slesinger/bobik_robot/meshes/wheel.png

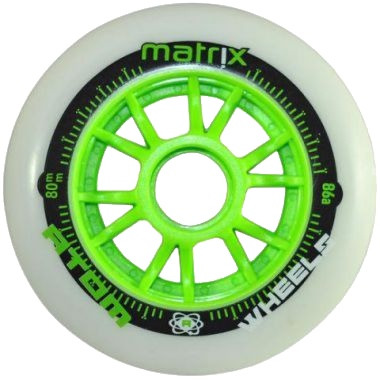
meshes/wheel.png
