slesinger/bobik_robot/docs/CAD/bobik-assembly.FCStd

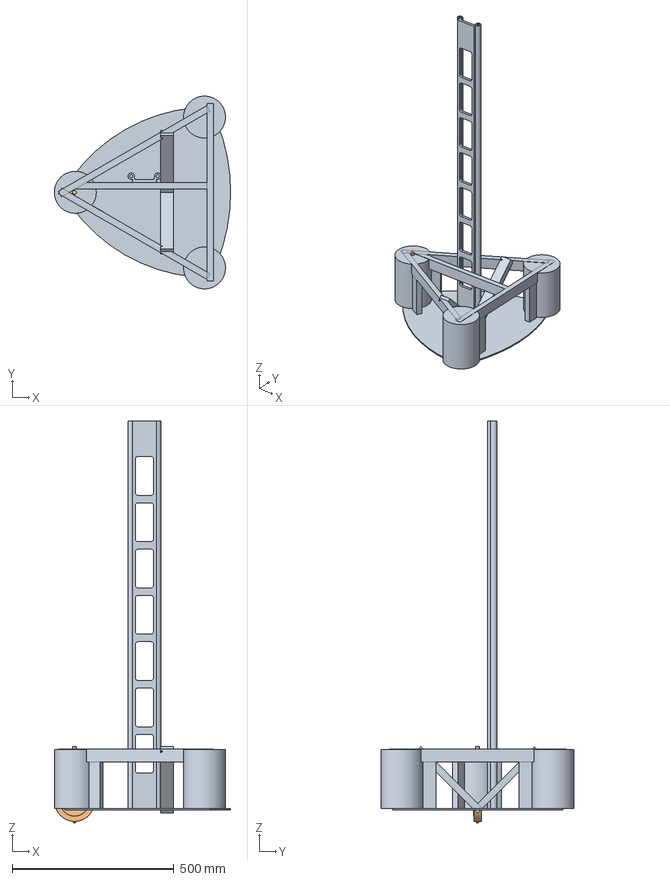
[picture p2: CAD file, 2022-05-19]
docs/CAD/bobik-assembly.FCStd
545.7 x 596.9 x 1244.4 mm
base-fixed_001
drive-module-holder_v2_001
