slesinger/bobik_robot/docs/CAD/base_link/torso-stepper-bearing.FCStd

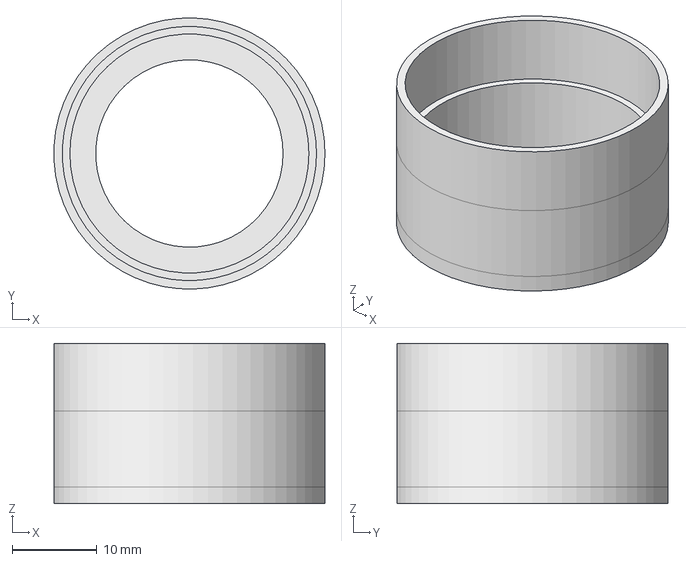
[picture p3: CAD file, 2022-06-24]
docs/CAD/base_link/torso-stepper-bearing.FCStd
32.0 x 32.0 x 18.9 mm
