slesinger/bobik_robot/docs/CAD/caster_rotation_link/drive-rotation-tgear176-Cut.stl

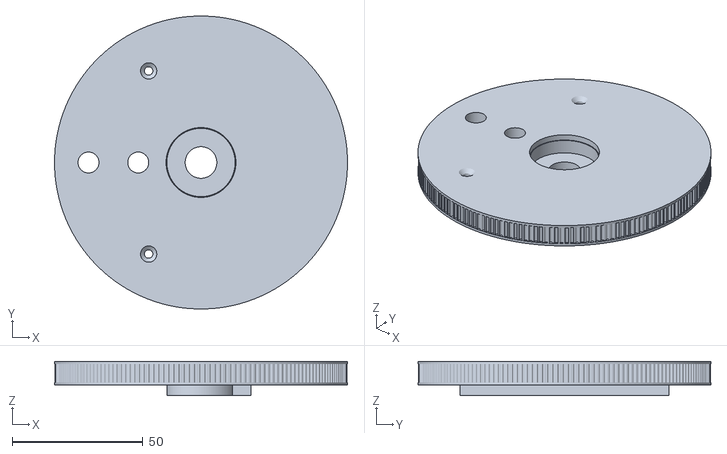
[picture p4: CAD file, 2022-05-19]
docs/CAD/caster_rotation_link/drive-rotation-tgear176-Cut.stl
112.0 x 112.0 x 13.0
