slesinger/bobik_robot/docs/CAD/electrical/imu-holder.stl

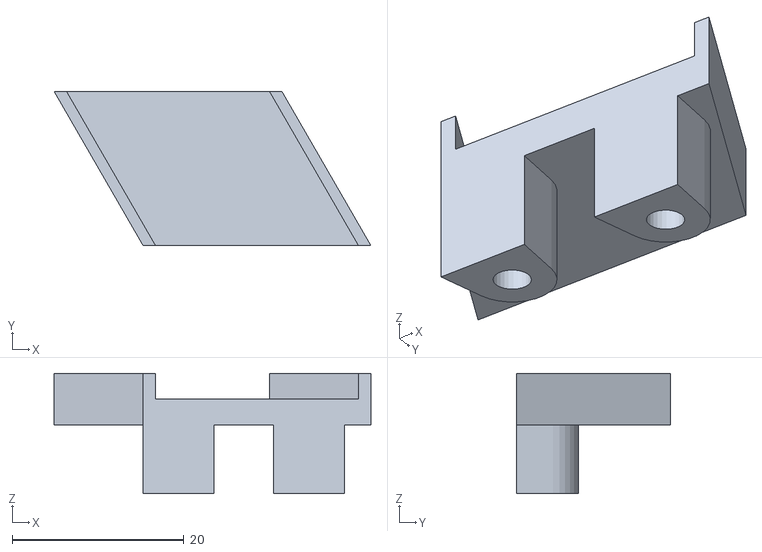
[picture p5: CAD file, 2022-07-30]
docs/CAD/electrical/imu-holder.stl
37.0 x 18.0 x 14.0
