slesinger/bobik_robot/docs/CAD/head_pan_link/head_pan_link.FCStd

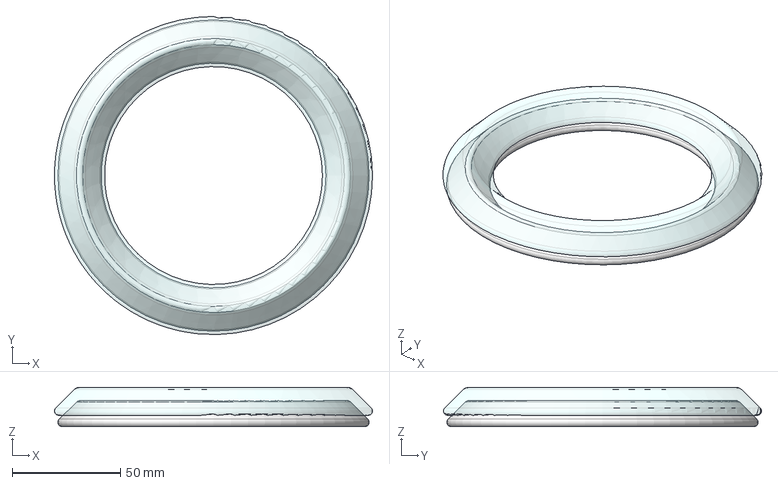
[picture p6: CAD file, 2022-06-17]
docs/CAD/head_pan_link/head_pan_link.FCStd
147.2 x 147.2 x 18.1 mm
