slesinger/bobik_robot/docs/mechanical/arm.FCStd

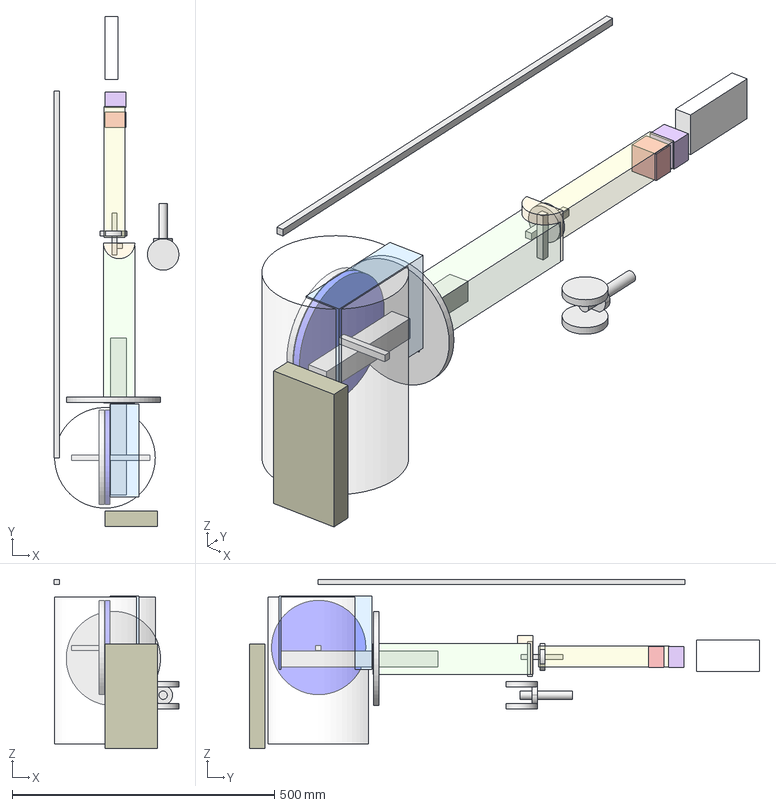
[picture p7: CAD file, 2022-05-19]
docs/mechanical/arm.FCStd
238.0 x 973.0 x 323.0 mm
torso_lift_link
shoulder_pan_link
shoulder_left_link
upper_arm_roll_link
forearm_roll_link
wrist flex link
wrist roll_link
gripper palm link
shoulder-palmwrist-measure
shoulder_tbelt
shoulder_forspring
shoulder_axis
upper_am_roll-axis
elbow_flex_link
elbow_flex_link-axis
forearm roll joint-axis
