slesinger/bobik_robot/docs/CAD/base_link/torso-stepper-holder.FCStd

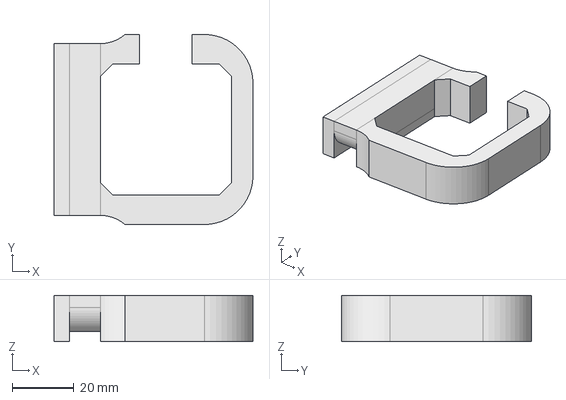
[picture p8: CAD file, 2022-06-24]
docs/CAD/base_link/torso-stepper-holder.FCStd
64.4 x 61.5 x 15.0 mm
