slesinger/bobik_robot/docs/CAD/bobik-urdf-meshes.FCStd

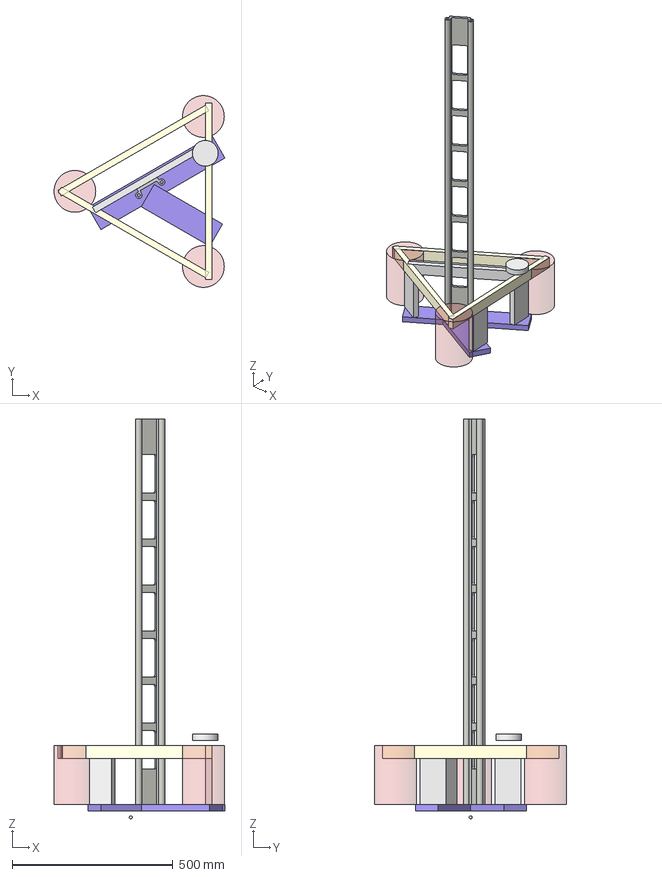
[picture p9: CAD file, 2022-05-19]
docs/CAD/bobik-urdf-meshes.FCStd
531.9 x 596.9 x 1245.0 mm
triangle
ZERO
prostredni
lidar
plech100
plech101
