slesinger/bobik_robot/docs/CAD/caster_rotation_link/drive-module-holder_v2.FCStd

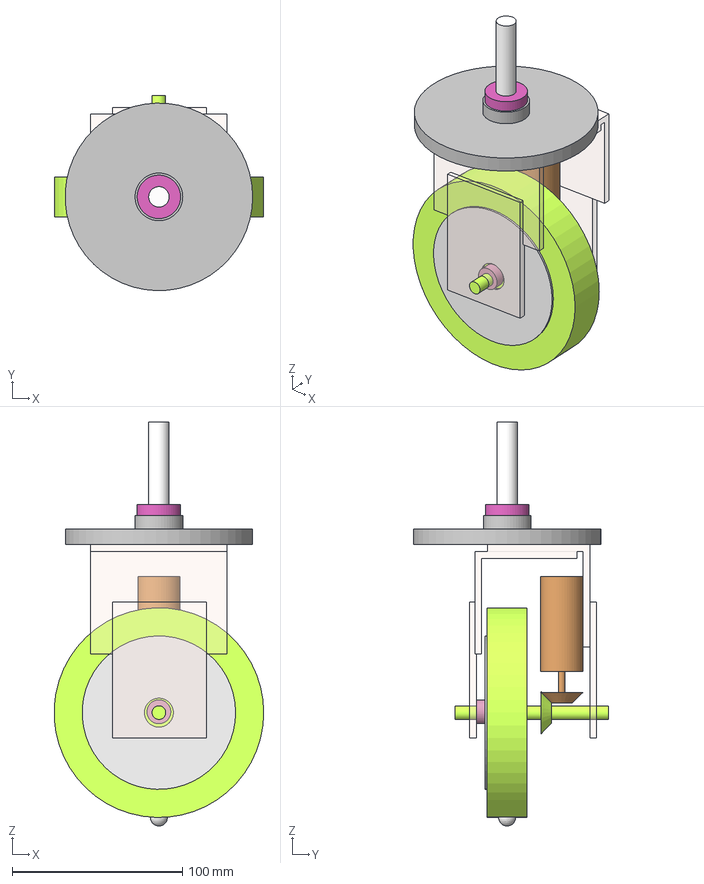
[picture p10: CAD file, 2022-05-19]
docs/CAD/caster_rotation_link/drive-module-holder_v2.FCStd
122.9 x 114.5 x 237.0 mm
ZERO
axial-bearing
rotation-axis
motor001
matka
Ushape
wheen_and_axis
wheel_encoder
rotation
