slesinger/bobik_robot/docs/CAD/electrical/controlpanel-holder.stl

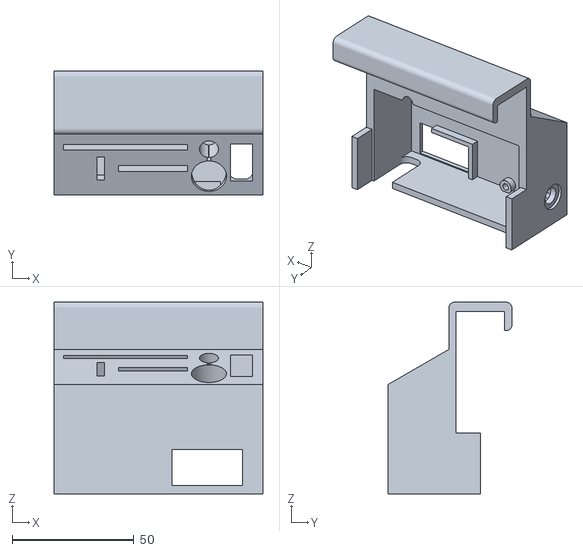
[picture p11: CAD file, 2022-07-30]
docs/CAD/electrical/controlpanel-holder.stl
86.0 x 51.0 x 78.9
