slesinger/bobik_robot/docs/CAD/head_pan_link/temp-kinect.FCStd

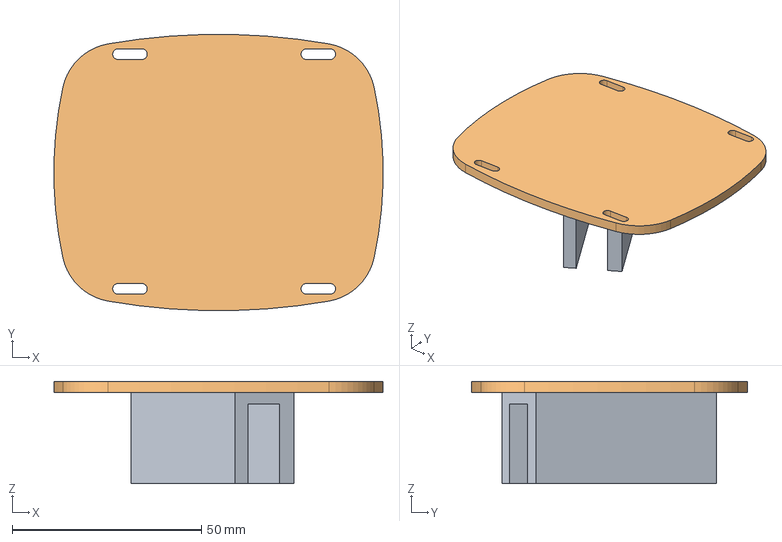
[picture p12: CAD file, 2022-06-17]
docs/CAD/head_pan_link/temp-kinect.FCStd
86.9 x 72.9 x 27.0 mm
