slesinger/bobik_robot/docs/CAD/base_link/rotation-absolute-holder.FCStd

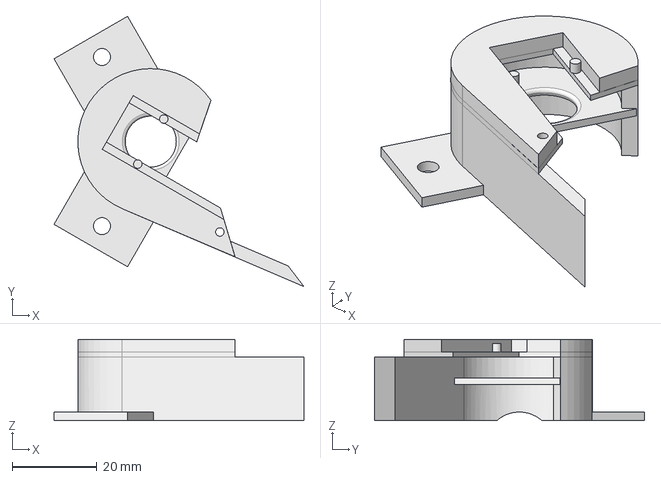
[picture p13: CAD file, 2022-05-19]
docs/CAD/base_link/rotation-absolute-holder.FCStd
58.9 x 63.7 x 19.1 mm
