slesinger/bobik_robot/docs/CAD/caster_rotation_link/rotation-magnet-holder.FCStd

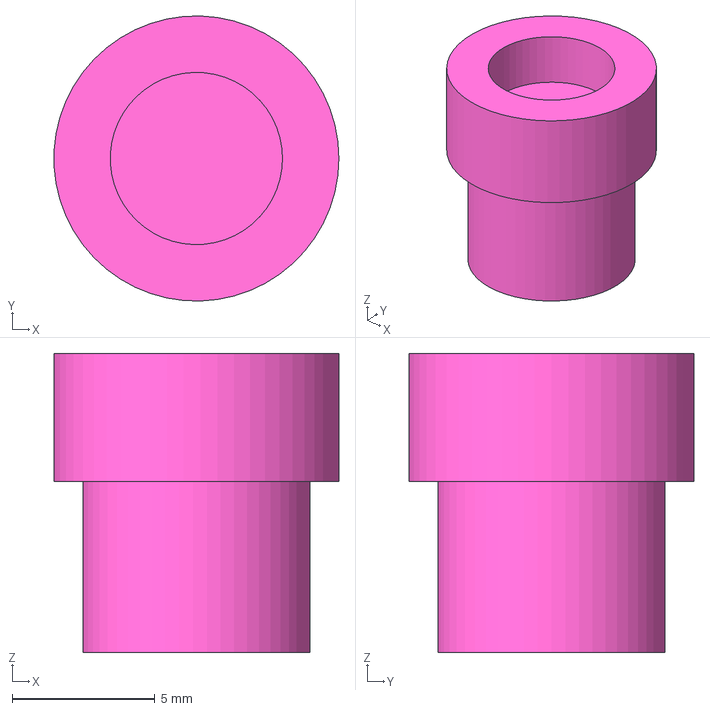
[picture p14: CAD file, 2022-05-19]
docs/CAD/caster_rotation_link/rotation-magnet-holder.FCStd
9.99 x 10.00 x 10.5 mm
