slesinger/bobik_robot/docs/CAD/head_pan_link/head_pan_link_v2.FCStd

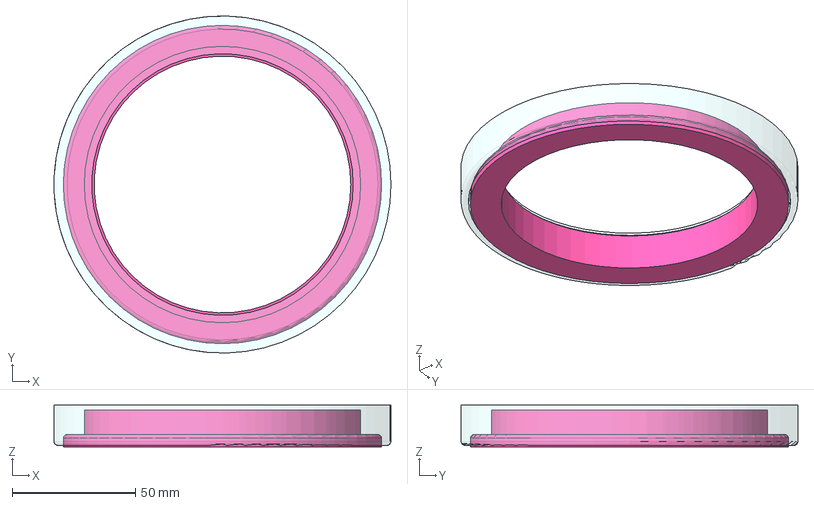
[picture p15: CAD file, 2022-06-17]
docs/CAD/head_pan_link/head_pan_link_v2.FCStd
136.6 x 136.5 x 16.9 mm
