slesinger/bobik_robot/docs/CAD/base_link/base_link.FCStd

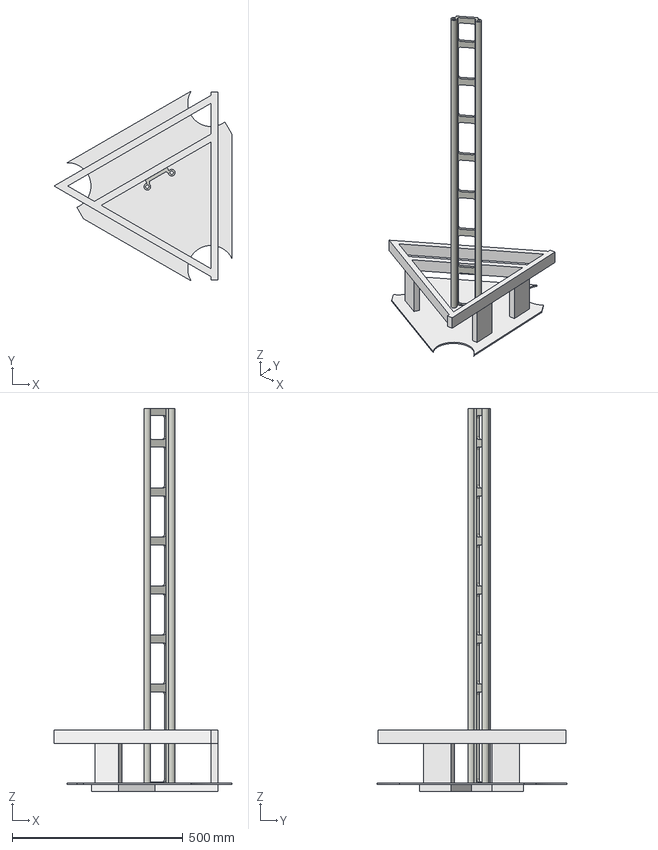
[picture p16: CAD file, 2022-05-19]
docs/CAD/base_link/base_link.FCStd
520.2 x 555.3 x 1120.0 mm
triangle
stand-front-left
stand-front-right
stand-rear
y-bottom
