slesinger/bobik_robot/docs/CAD/electrical/imu.FCStd

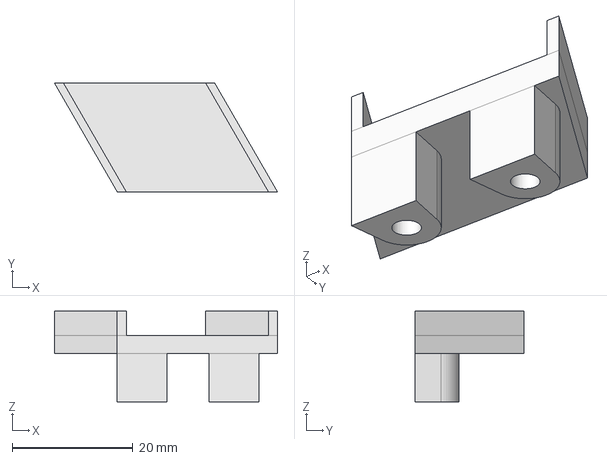
[picture p17: CAD file, 2022-07-09]
docs/CAD/electrical/imu.FCStd
37.0 x 18.0 x 15.0 mm
