slesinger/bobik_robot/docs/CAD/base_link/rotation-motor-holder.FCStd

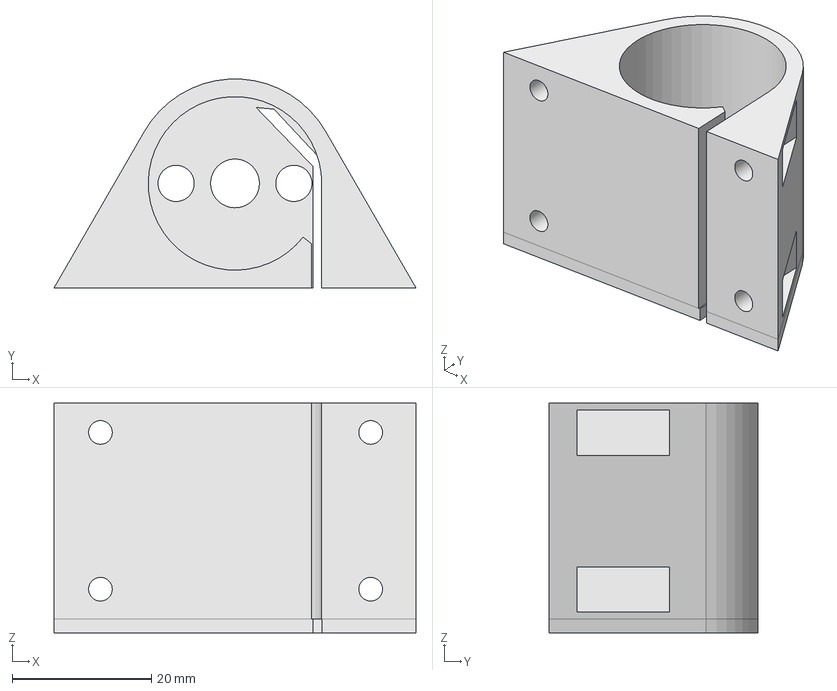
[picture p18: CAD file, 2022-05-19]
docs/CAD/base_link/rotation-motor-holder.FCStd
52.0 x 30.0 x 33.0 mm
