slesinger/bobik_robot/docs/CAD/caster_rotation_link/drive-motor-holder-a.FCStd

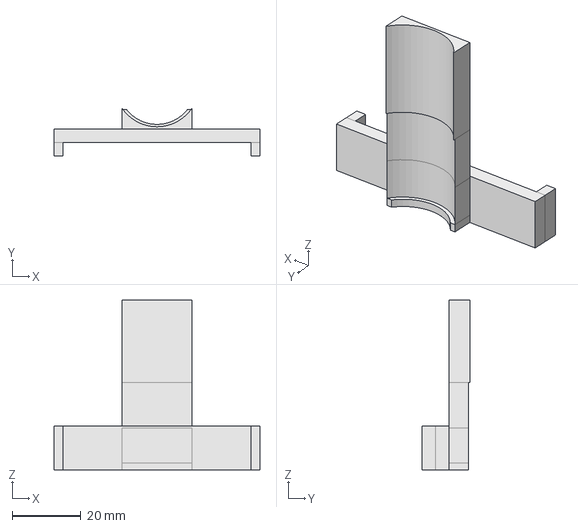
[picture p19: CAD file, 2022-05-19]
docs/CAD/caster_rotation_link/drive-motor-holder-a.FCStd
60.0 x 14.1 x 49.5 mm
