slesinger/bobik_robot/docs/CAD/electrical/antenna-holder-antenna-holder1.stl

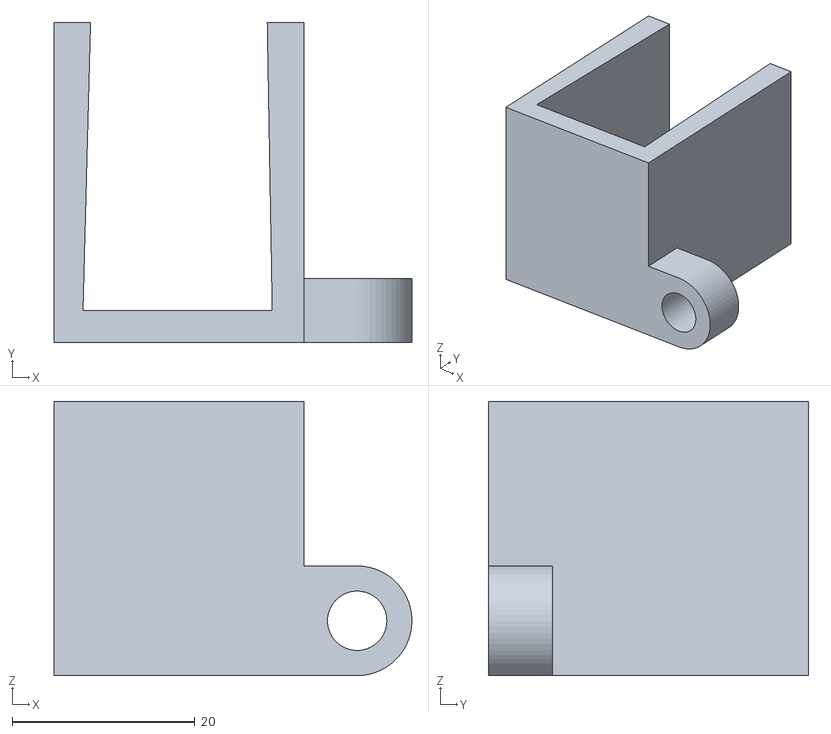
[picture p20: CAD file, 2022-06-24]
docs/CAD/electrical/antenna-holder-antenna-holder1.stl
39.2 x 35.0 x 30.0
