slesinger/bobik_robot/docs/CAD/base_link/base_link-backup.FCStd

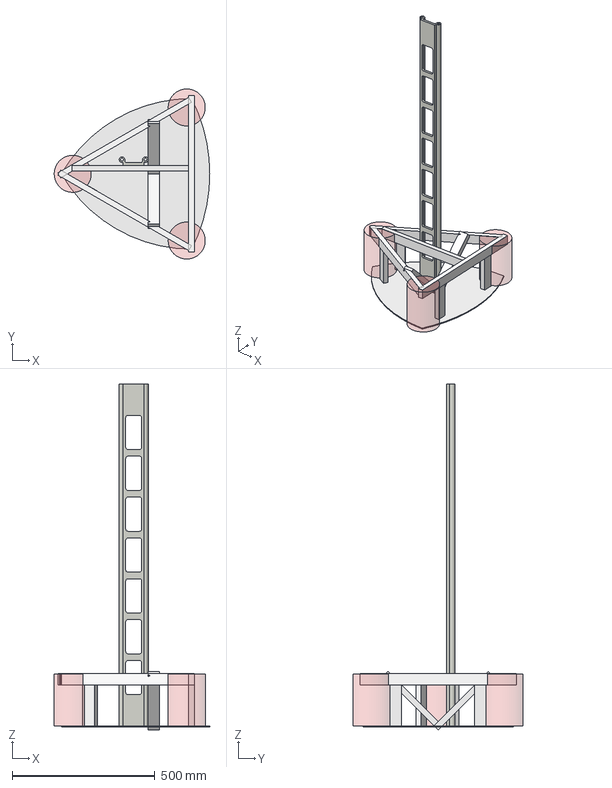
[picture p21: CAD file, 2022-05-19]
docs/CAD/base_link/base_link-backup.FCStd
545.7 x 596.9 x 1214.0 mm
triangle
prostredni
