slesinger/bobik_robot/docs/CAD/caster_rotation_link/wheel-odometry-holder.FCStd

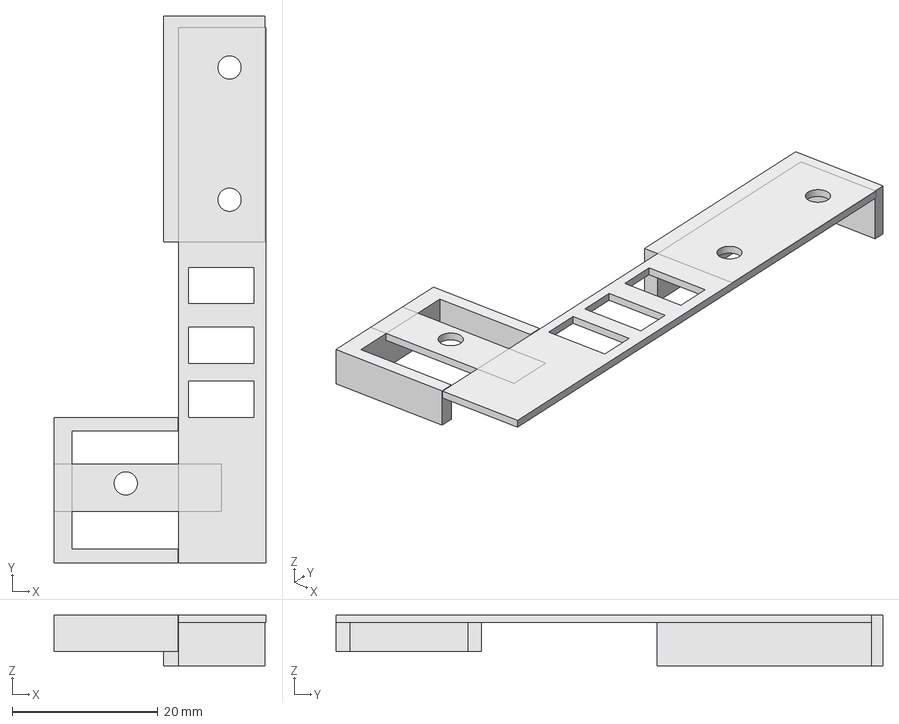
[picture p22: CAD file, 2022-05-19]
docs/CAD/caster_rotation_link/wheel-odometry-holder.FCStd
29.1 x 75.1 x 7.00 mm
