slesinger/bobik_robot/docs/CAD/electrical/thething-holder.FCStd

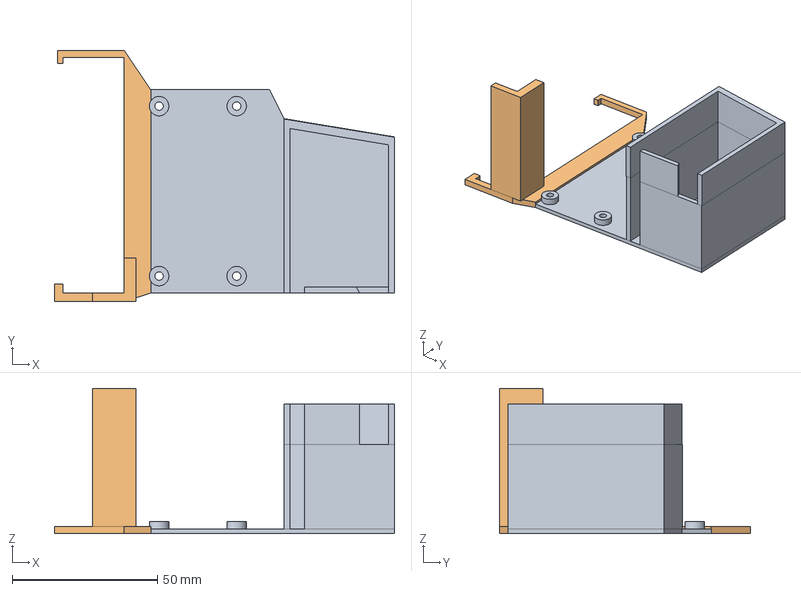
[picture p23: CAD file, 2022-06-24]
docs/CAD/electrical/thething-holder.FCStd
117.0 x 86.5 x 50.0 mm
