slesinger/bobik_robot/docs/CAD/base_link/rotation-motor-biholder.FCStd

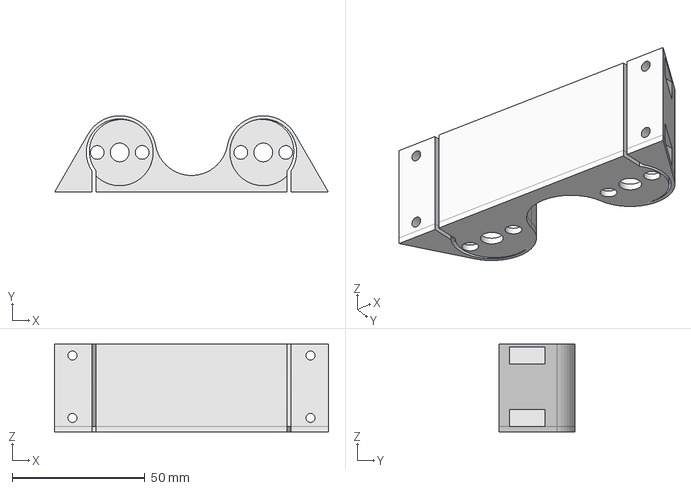
[picture p24: CAD file, 2022-05-19]
docs/CAD/base_link/rotation-motor-biholder.FCStd
103.1 x 28.7 x 33.0 mm
