slesinger/bobik_robot/docs/CAD/caster_rotation_link/wheel-codewheel-radial-plus25.stl

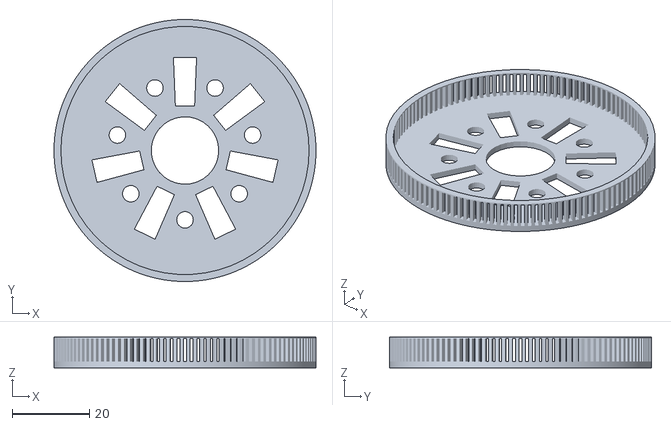
[picture p25: CAD file, 2022-05-19]
docs/CAD/caster_rotation_link/wheel-codewheel-radial-plus25.stl
68.0 x 68.0 x 8.00
