slesinger/bobik_robot/docs/CAD/electrical/floor1-distancers.FCStd

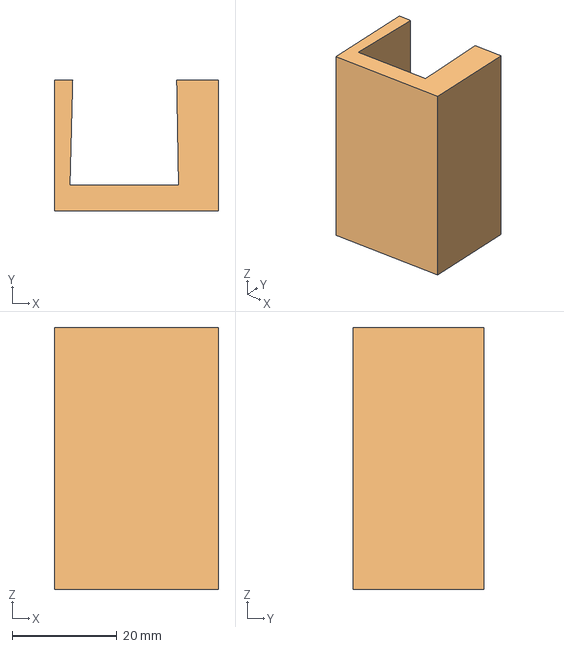
[picture p26: CAD file, 2022-06-24]
docs/CAD/electrical/floor1-distancers.FCStd
31.3 x 25.0 x 50.0 mm
