slesinger/bobik_robot/docs/CAD/base_link/el-charger-shelf-l.stl

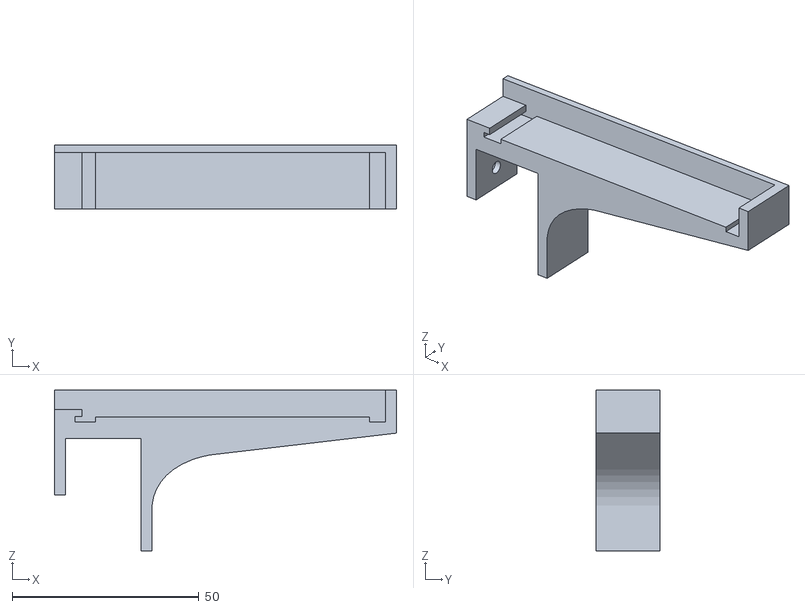
[picture p27: CAD file, 2022-05-19]
docs/CAD/base_link/el-charger-shelf-l.stl
91.5 x 17.0 x 43.0
