slesinger/bobik_robot/docs/CAD/caster_rotation_link/wheel-codewheel-radial.FCStd

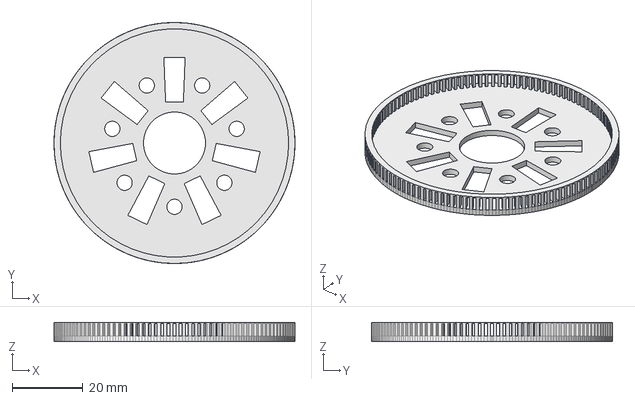
[picture p28: CAD file, 2022-05-19]
docs/CAD/caster_rotation_link/wheel-codewheel-radial.FCStd
68.0 x 68.0 x 5.50 mm
