slesinger/bobik_robot/docs/CAD/base_link/el-l298n-pilar.FCStd

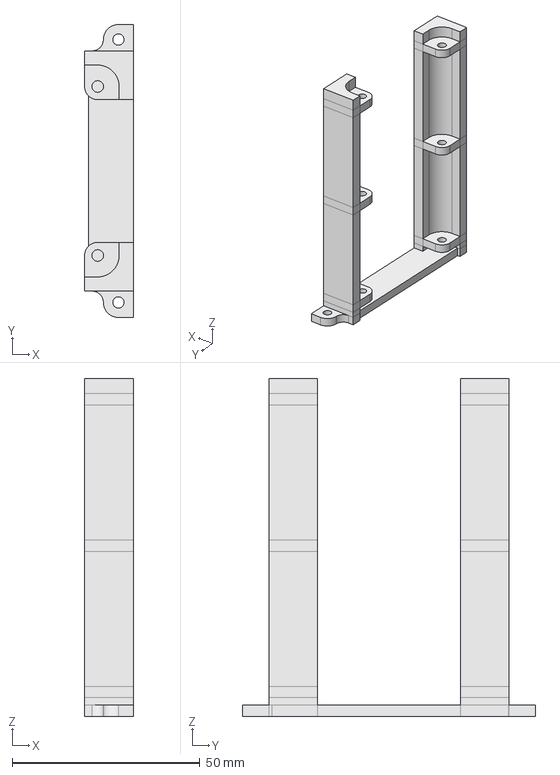
[picture p29: CAD file, 2022-05-19]
docs/CAD/base_link/el-l298n-pilar.FCStd
13.0 x 78.0 x 90.0 mm
