slesinger/bobik_robot/docs/CAD/caster_rotation_link/wheel-codewheel-radial-plus19.stl

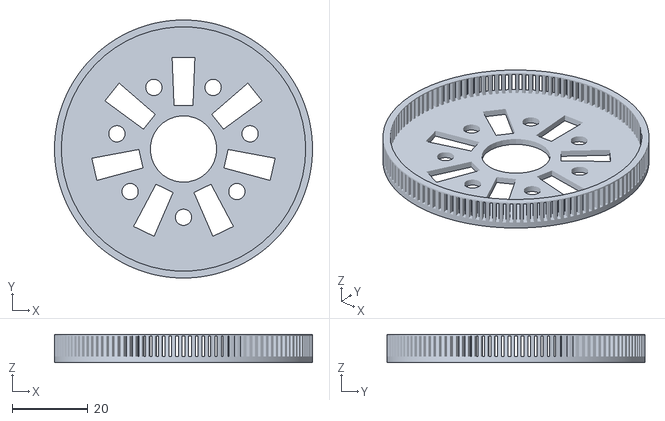
[picture p30: CAD file, 2022-05-19]
docs/CAD/caster_rotation_link/wheel-codewheel-radial-plus19.stl
68.0 x 68.0 x 7.40
