slesinger/bobik_robot/docs/CAD/electrical/antenna-holder-antenna-holder2.stl

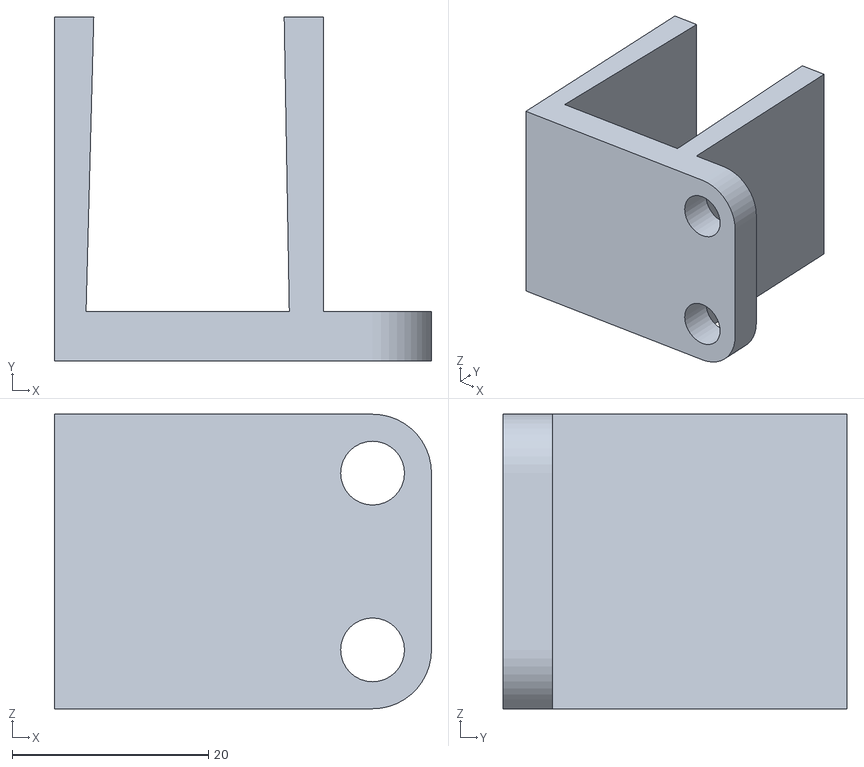
[picture p31: CAD file, 2022-05-27]
docs/CAD/electrical/antenna-holder-antenna-holder2.stl
38.4 x 35.0 x 30.0
