slesinger/bobik_robot/docs/CAD/base_link/rotation-axis-drill-helper.stl

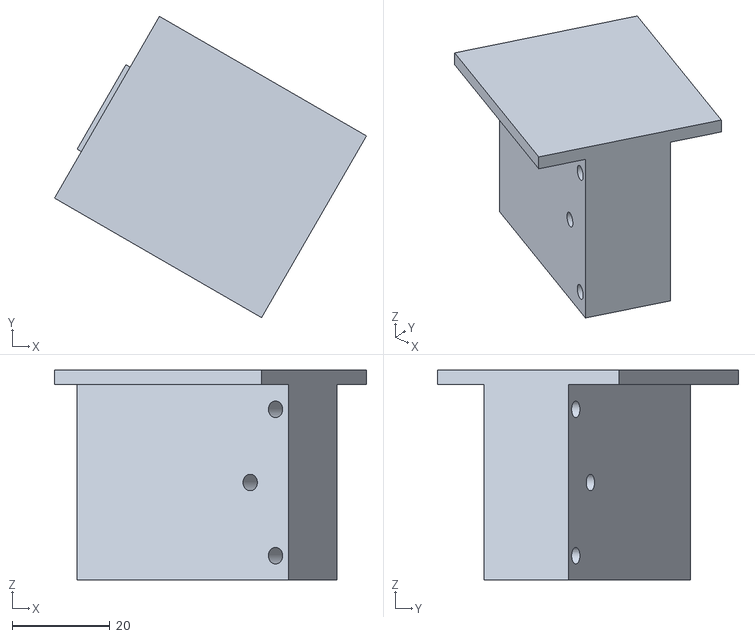
[picture p32: CAD file, 2022-05-19]
docs/CAD/base_link/rotation-axis-drill-helper.stl
63.9 x 61.7 x 43.0
