slesinger/bobik_robot/docs/CAD/caster_rotation_link/caster_rotation_link.FCStd

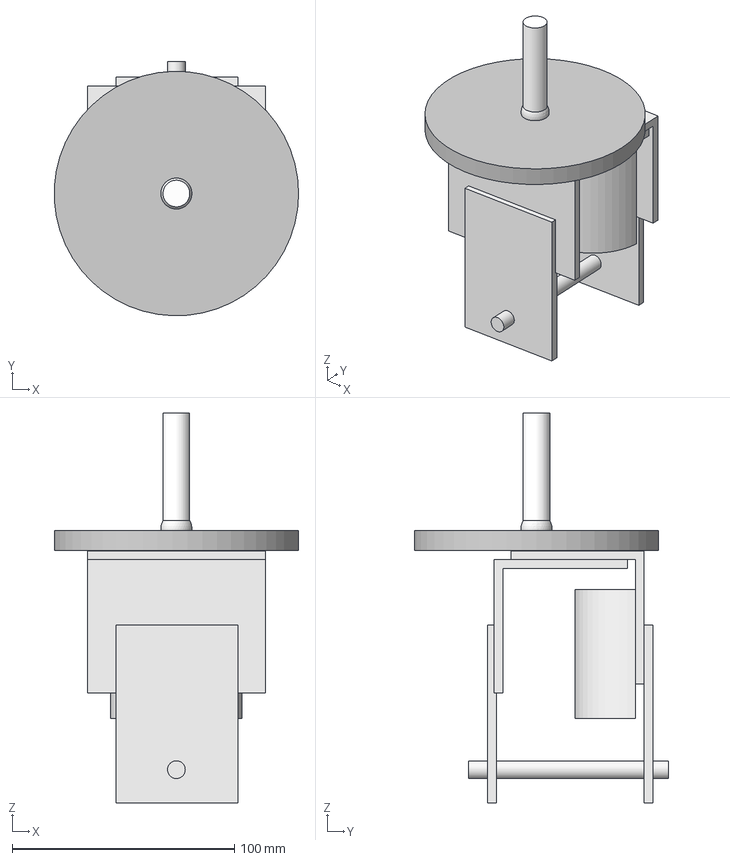
[picture p33: CAD file, 2022-05-19]
docs/CAD/caster_rotation_link/caster_rotation_link.FCStd
109.9 x 114.5 x 175.5 mm
ZERO
wheel-axis
rotation-axis
Lshape002
side001
side002
Lshape001
rotation-gt2
