slesinger/bobik_robot/docs/CAD/electrical/floor1-distancers-center.stl

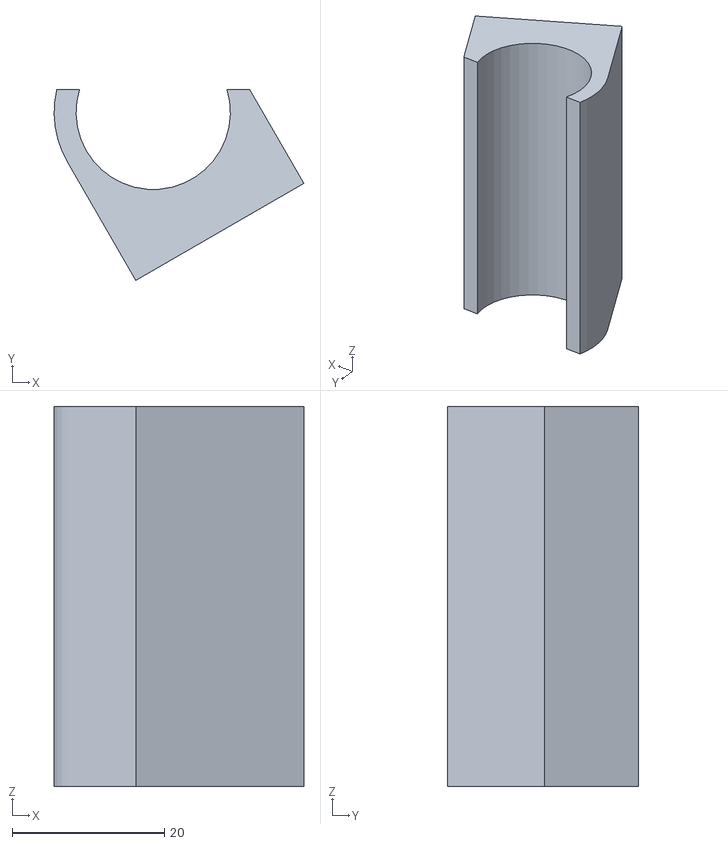
[picture p34: CAD file, 2022-05-19]
docs/CAD/electrical/floor1-distancers-center.stl
32.9 x 25.1 x 50.0
