slesinger/bobik_robot/docs/CAD/electrical/power_stepdowns-a.FCStd

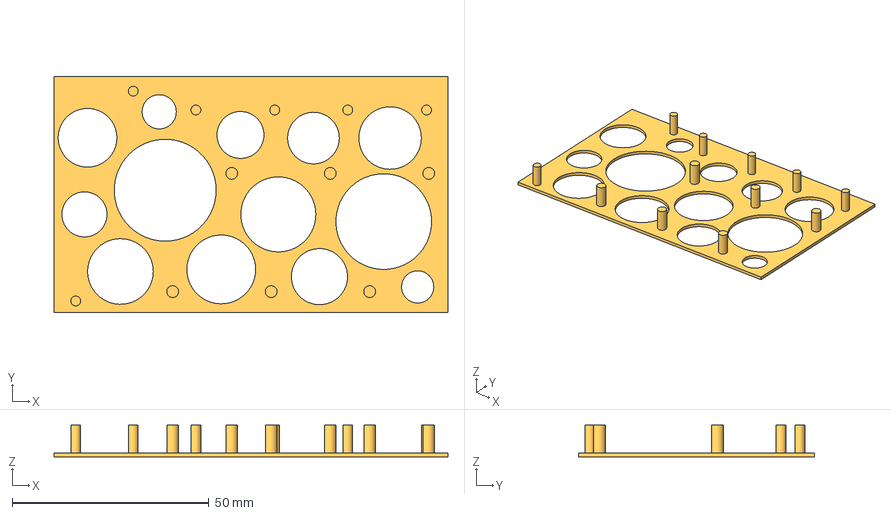
[picture p35: CAD file, 2022-05-19]
docs/CAD/electrical/power_stepdowns-a.FCStd
100.0 x 60.0 x 8.00 mm
