slesinger/bobik_robot/docs/CAD/base_link/rotation-axis-holder.FCStd

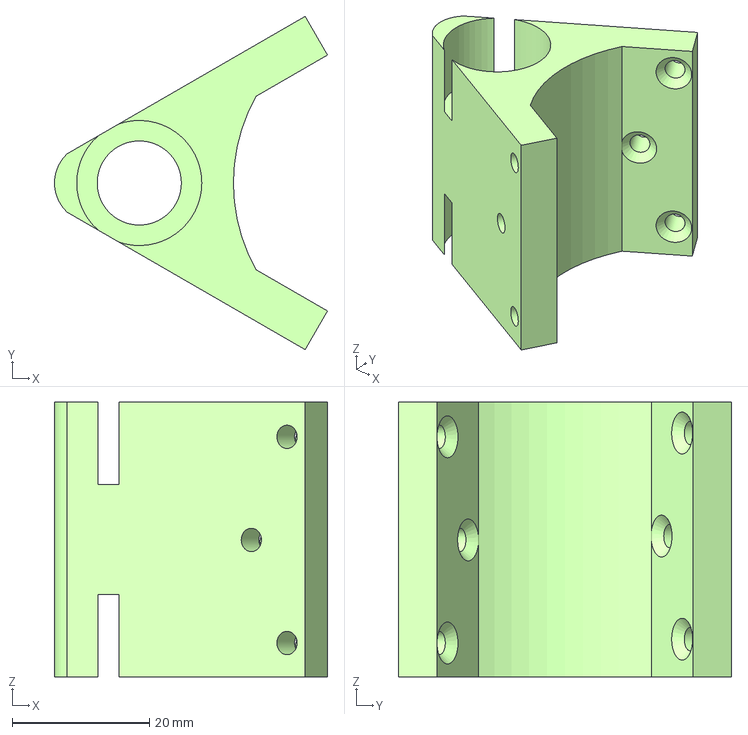
[picture p36: CAD file, 2022-05-19]
docs/CAD/base_link/rotation-axis-holder.FCStd
39.7 x 48.5 x 40.0 mm
