slesinger/bobik_robot/docs/CAD/electrical/floor1-distancers-front.stl

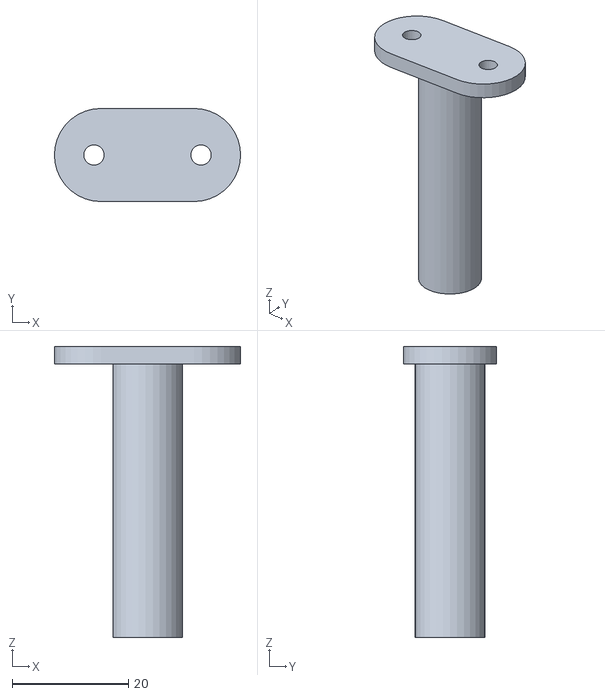
[picture p38: CAD file, 2022-05-19]
docs/CAD/electrical/floor1-distancers-front.stl
32.0 x 16.0 x 50.0
