slesinger/bobik_robot/docs/CAD/base_link/rotation-axis-helper.stl

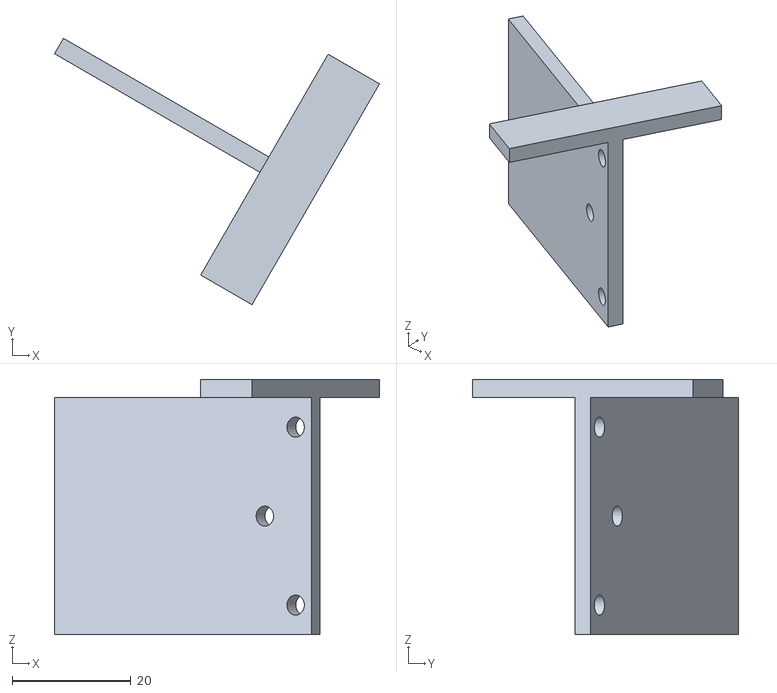
[picture p39: CAD file, 2022-05-19]
docs/CAD/base_link/rotation-axis-helper.stl
54.8 x 44.9 x 43.0
