slesinger/bobik_robot/docs/CAD/electrical/floor1-distancers-left-right.stl

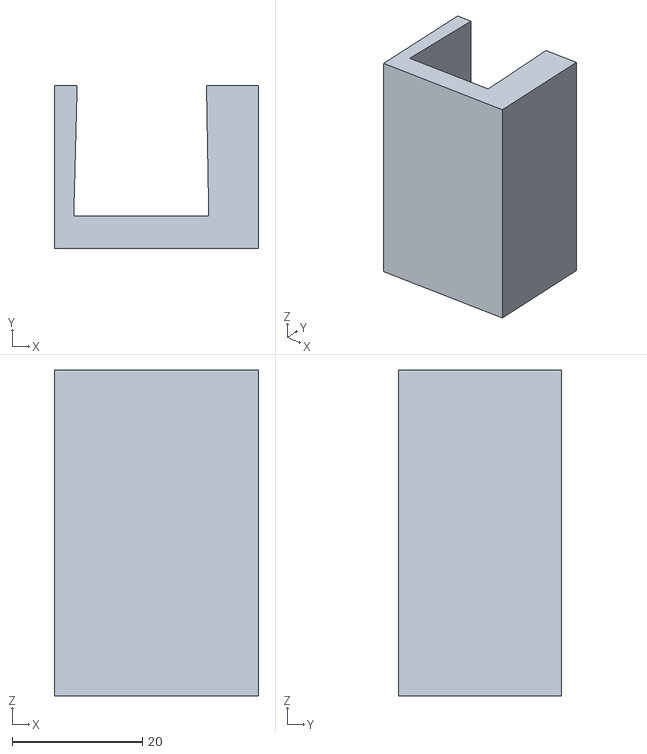
[picture p40: CAD file, 2022-05-19]
docs/CAD/electrical/floor1-distancers-left-right.stl
31.3 x 25.0 x 50.0
