slesinger/bobik_robot/docs/CAD/base_link/el-dc-dc-holder.FCStd

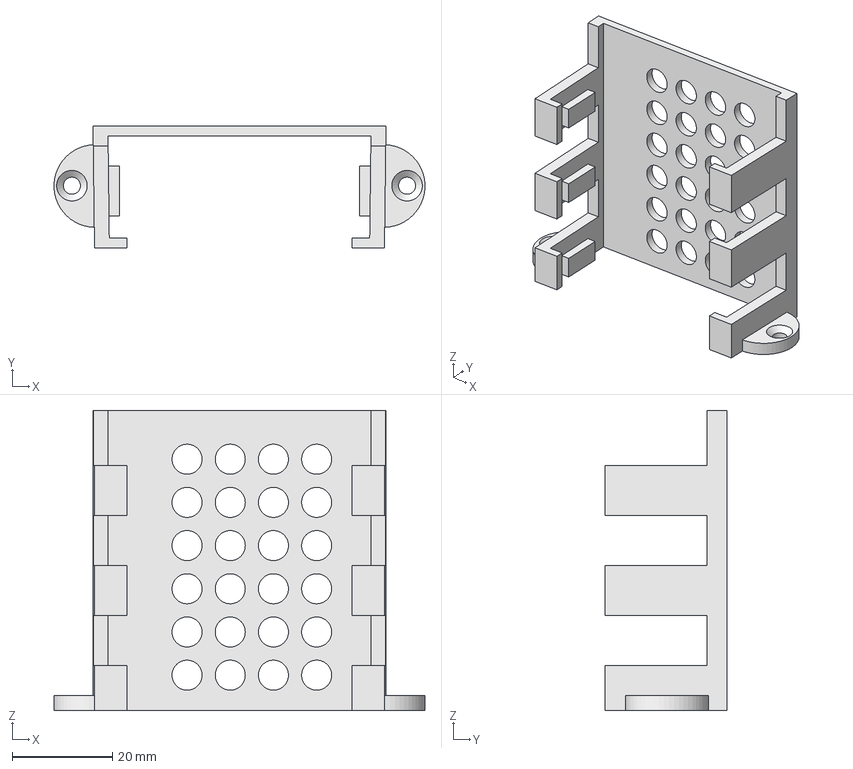
[picture p41: CAD file, 2022-05-19]
docs/CAD/base_link/el-dc-dc-holder.FCStd
74.1 x 24.4 x 60.0 mm
