slesinger/bobik_robot/docs/CAD/caster_rotation_link/drive-motor-holder-b.FCStd

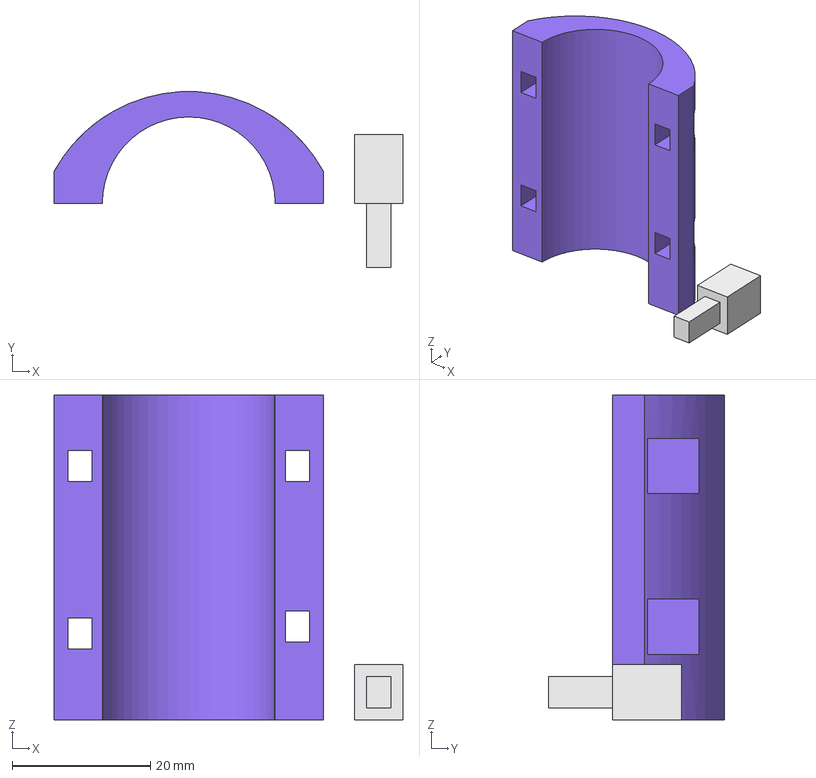
[picture p42: CAD file, 2022-05-19]
docs/CAD/caster_rotation_link/drive-motor-holder-b.FCStd
50.5 x 25.4 x 47.0 mm
