slesinger/bobik_robot/docs/CAD/base_link/el-powerswitch.FCStd

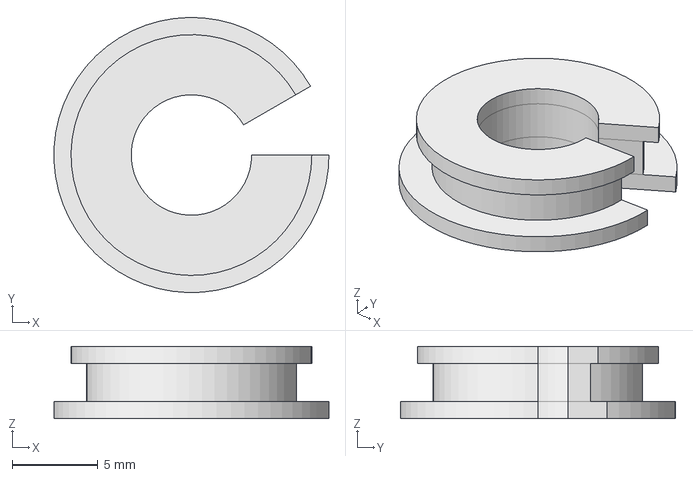
[picture p43: CAD file, 2022-05-19]
docs/CAD/base_link/el-powerswitch.FCStd
16.0 x 16.0 x 4.20 mm
