slesinger/bobik_robot/docs/CAD/base_link/rotation-idler.FCStd

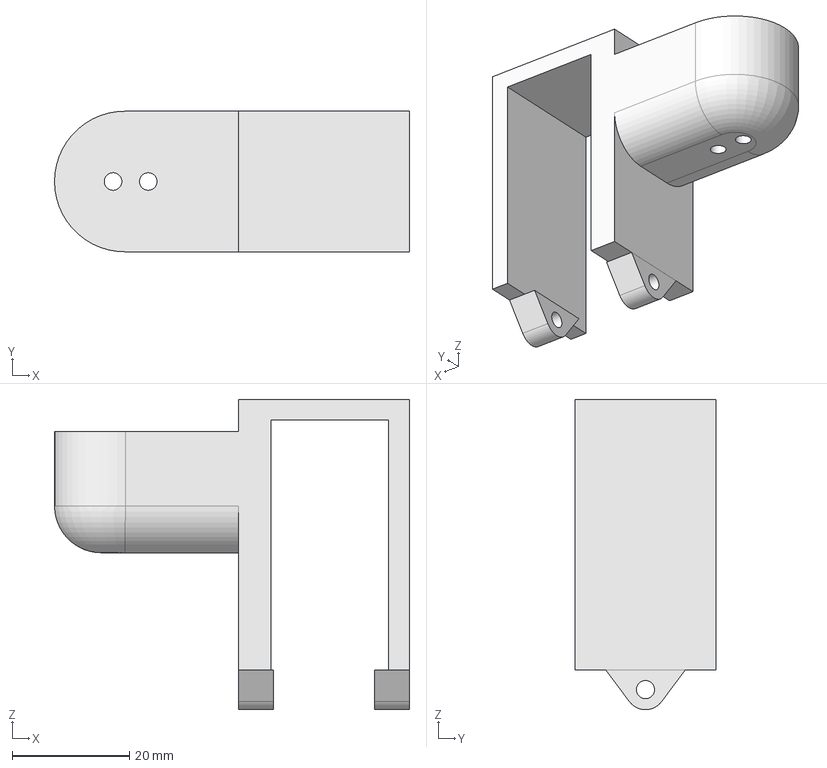
[picture p44: CAD file, 2022-05-19]
docs/CAD/base_link/rotation-idler.FCStd
60.6 x 24.0 x 53.0 mm
