slesinger/bobik_robot/docs/CAD/base_link/base_link_collision.FCStd

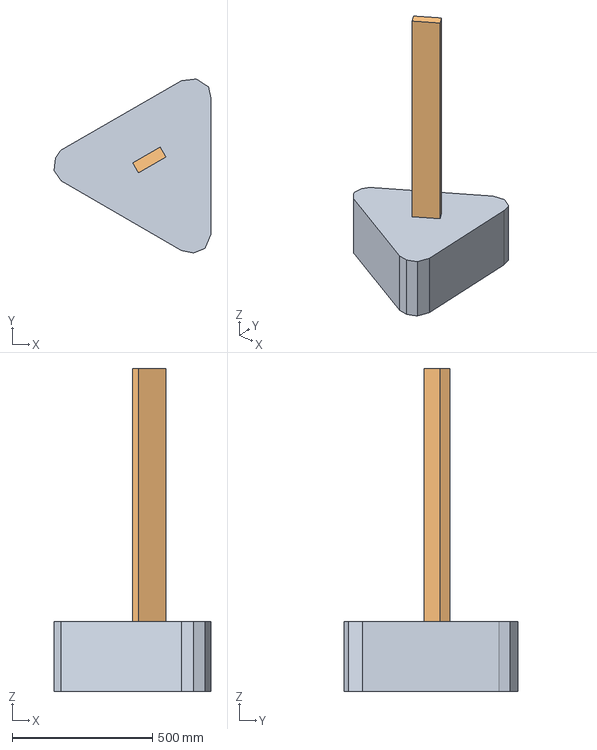
[picture p45: CAD file, 2022-05-19]
docs/CAD/base_link/base_link_collision.FCStd
558.9 x 619.5 x 1150.0 mm
base
torso
