slesinger/bobik_robot/docs/CAD/base_link/temp.stl

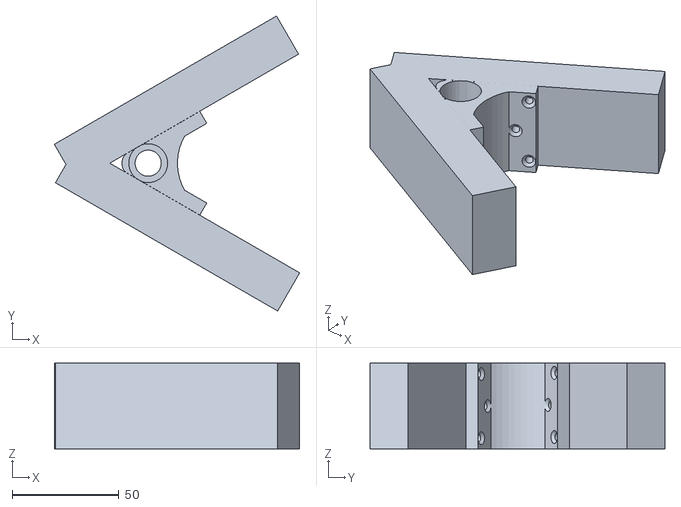
[picture p46: CAD file, 2022-05-19]
docs/CAD/base_link/temp.stl
114.7 x 138.0 x 40.0
