slesinger/bobik_robot/(list of files, cad)

Other CAD files:
docs/CAD/electrical/controlpanel.FCStd
docs/CAD/caster_rotation_link/rotation-magnet-holder-fl.stl
docs/CAD/electrical/antenna-holder.FCStd
docs/CAD/base_link/floor1-powerdistribution.FCStd
docs/CAD/caster_rotation_link/drive-rotation-tgear176.FCStd
docs/CAD/caster_rotation_link/drive-motor-holder-a-0mm.stl
docs/CAD/base_link/el-charger-shelf.FCStd
docs/CAD/base_link/el-l298n-2pilars.stl
docs/CAD/base_link/el-charger-shelf-r.stl
docs/CAD/base_link/rotation-absolute-holder-b.stl
docs/CAD/backup/absolute-rotation-test-magnet-drzak-rotor.stl
docs/CAD/backup/absolute-rotation-test-magnet-drzak-stator.stl
docs/CAD/backup/absolute-rotation-test.FCStd
docs/CAD/backup/absolute-rotation-test2.FCStd
docs/CAD/backup/ass-assembly.FCStd
docs/CAD/backup/ass-part.FCStd
docs/CAD/backup/drive-module-differential.FCStd
docs/CAD/backup/drive-module-holder.FCStd
docs/CAD/backup/drive-module-holder_v3-swerve.FCStd
docs/CAD/backup/hl-physical.FCStd
docs/CAD/backup/torso-security-endstop.stl
docs/CAD/base_link/el-dc-dc-holder.stl
docs/CAD/base_link/el-l298n-pilar.stl
docs/CAD/base_link/el-powerswitch.stl
docs/CAD/base_link/rotation-absolute-holder.stl
docs/CAD/base_link/rotation-axis-holder.stl
docs/CAD/base_link/rotation-idler.stl
docs/CAD/base_link/rotation-motor-biholder.stl
docs/CAD/base_link/rotation-motor-holder.stl
docs/CAD/base_link/torso-stepper-bearing.stl
docs/CAD/base_link/torso-stepper-holder.stl
docs/CAD/caster_rotation_link/drive-motor-holder-a.stl
docs/CAD/caster_rotation_link/drive-motor-holder-b.stl
docs/CAD/caster_rotation_link/rotation-magnet-holder.stl
docs/CAD/caster_rotation_link/wheel-codewheel-radial.stl
docs/CAD/caster_rotation_link/wheel-odometry-holder-b.stl
docs/CAD/caster_rotation_link/wheel-odometry-holder.stl
docs/CAD/electrical/power_stepdowns-a.stl
docs/CAD/electrical/thething-holder.stl
docs/CAD/head_pan_link/temp-kinect.stl
docs/CAD/torso_lift_link/trapeziodal-nut-holder.stl
docs/CAD/torso_lift_link/trapezoidal-nut-holder.FCStd
