slesinger/bobik_robot/(commit log)

2022-04-09 ekf setup
    [bobik_robot.urdf, bobik_robot.urdf.xacro]
2022-05-19 adding docs
    [absolute-rotation-test-magnet-drzak-rotor.stl, absolute-rotation-test-magnet-drzak-stator.stl, absolute-rotation-test.FCStd, absolute-rotation-test2.FCStd, arm.FCStd, ass-assembly.FCStd, ass-part.FCStd, base_link-backup.FCStd]
2022-05-27 human request
    [antenna-holder-antenna-holder2.stl, antenna-holder.FCStd, bobik_robot.urdf.xacro]
2022-06-17 services for tts
    [head_pan_link.FCStd, head_pan_link_v2.FCStd, temp-kinect.FCStd, temp-kinect.stl]
2022-06-24 basic nav2 working
    [antenna-holder-antenna-holder1.stl, antenna-holder.FCStd, floor1-distancers.FCStd, thething-holder.FCStd, thething-holder.stl, torso-stepper-bearing.FCStd, torso-stepper-bearing.stl, torso-stepper-holder.FCStd]
2022-06-26 switch robot playback from streaming to mpd
2022-07-06 adding imu, draft
    [bobik_robot.urdf.xacro, odometry.ods]
2022-07-09 odometry ekf fused with imu
    [imu.FCStd]
2022-07-17 slam toolbox progress
    [controlpanel.FCStd]
2022-07-30 ops updates
    [controlpanel-holder.stl, imu-holder.stl]
2026-10-25 docs: power system is built; document torso lift stepper
    Claude-Session: https://claude.ai/code/session_01FvUvD7jP5RHwvoE33gCLHR
2026-10-25 docs: add caster, Jetson and audio details from photos and owner answers
    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
2026-10-25 docs: restructure documentation from all original design files
    Mine electrical schema (power distribution as built), CAD dimensions,
    mechanical tree and legacy code into topic documents with an index;
    collect unknowns in one open-questions list.
    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
